doug-harriman/topo-box/images/usa-colorado-ouray/ouray-2.jpg

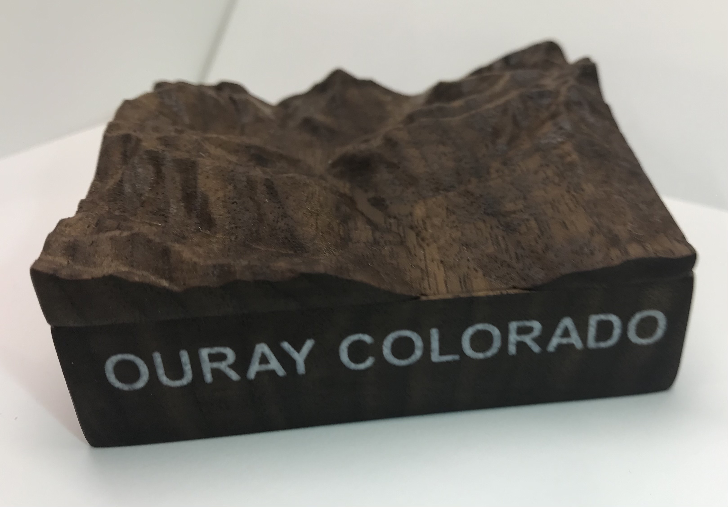
images/usa-colorado-ouray/ouray-2.jpg
