doug-harriman/topo-box/oregon-black-butte/images/proto-1-3d-print.jpg

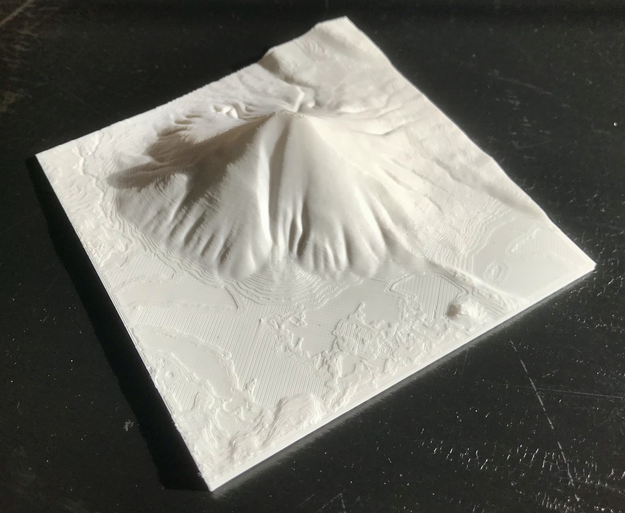
oregon-black-butte/images/proto-1-3d-print.jpg
