doug-harriman/topo-box/(commit log)

2021-06-20 Road finding and laser on/off for contours.
2021-06-22 Topo lines from STL now working.
2021-06-23 Captured photo of 3D print prototype.
2021-06-23 added STL view.
2021-06-23 Captured plan for generating contour line labels to STL in 3D.
2021-06-25 FDM print gcode from Cura added.
2021-06-27 New file to map SVG paths to STL surface for laser cutting.
2021-07-01 Added laser artwork for bottom.
2021-07-01 Added proto 1 top side laser mfg files.
